hgamal/midiclock/doc/midiclock_schematics.pdf

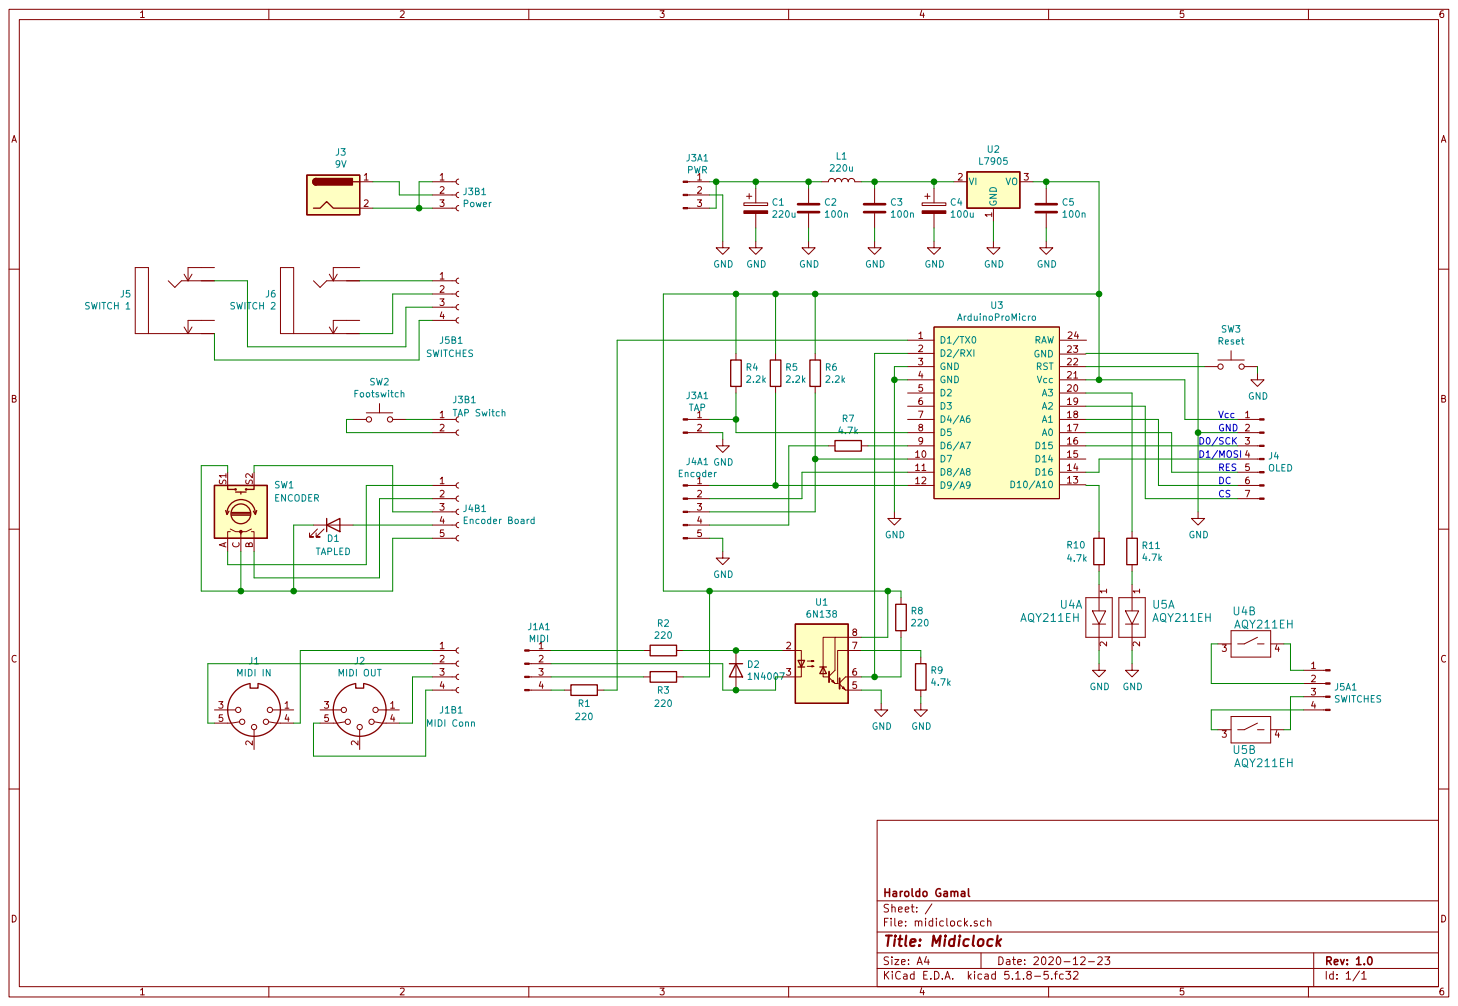
[picture p9: page 1]

File: midiclock.sch Sheet: / Haroldo Gamal
