hgamal/midiclock/doc/Pro-Micro-v10.pdf

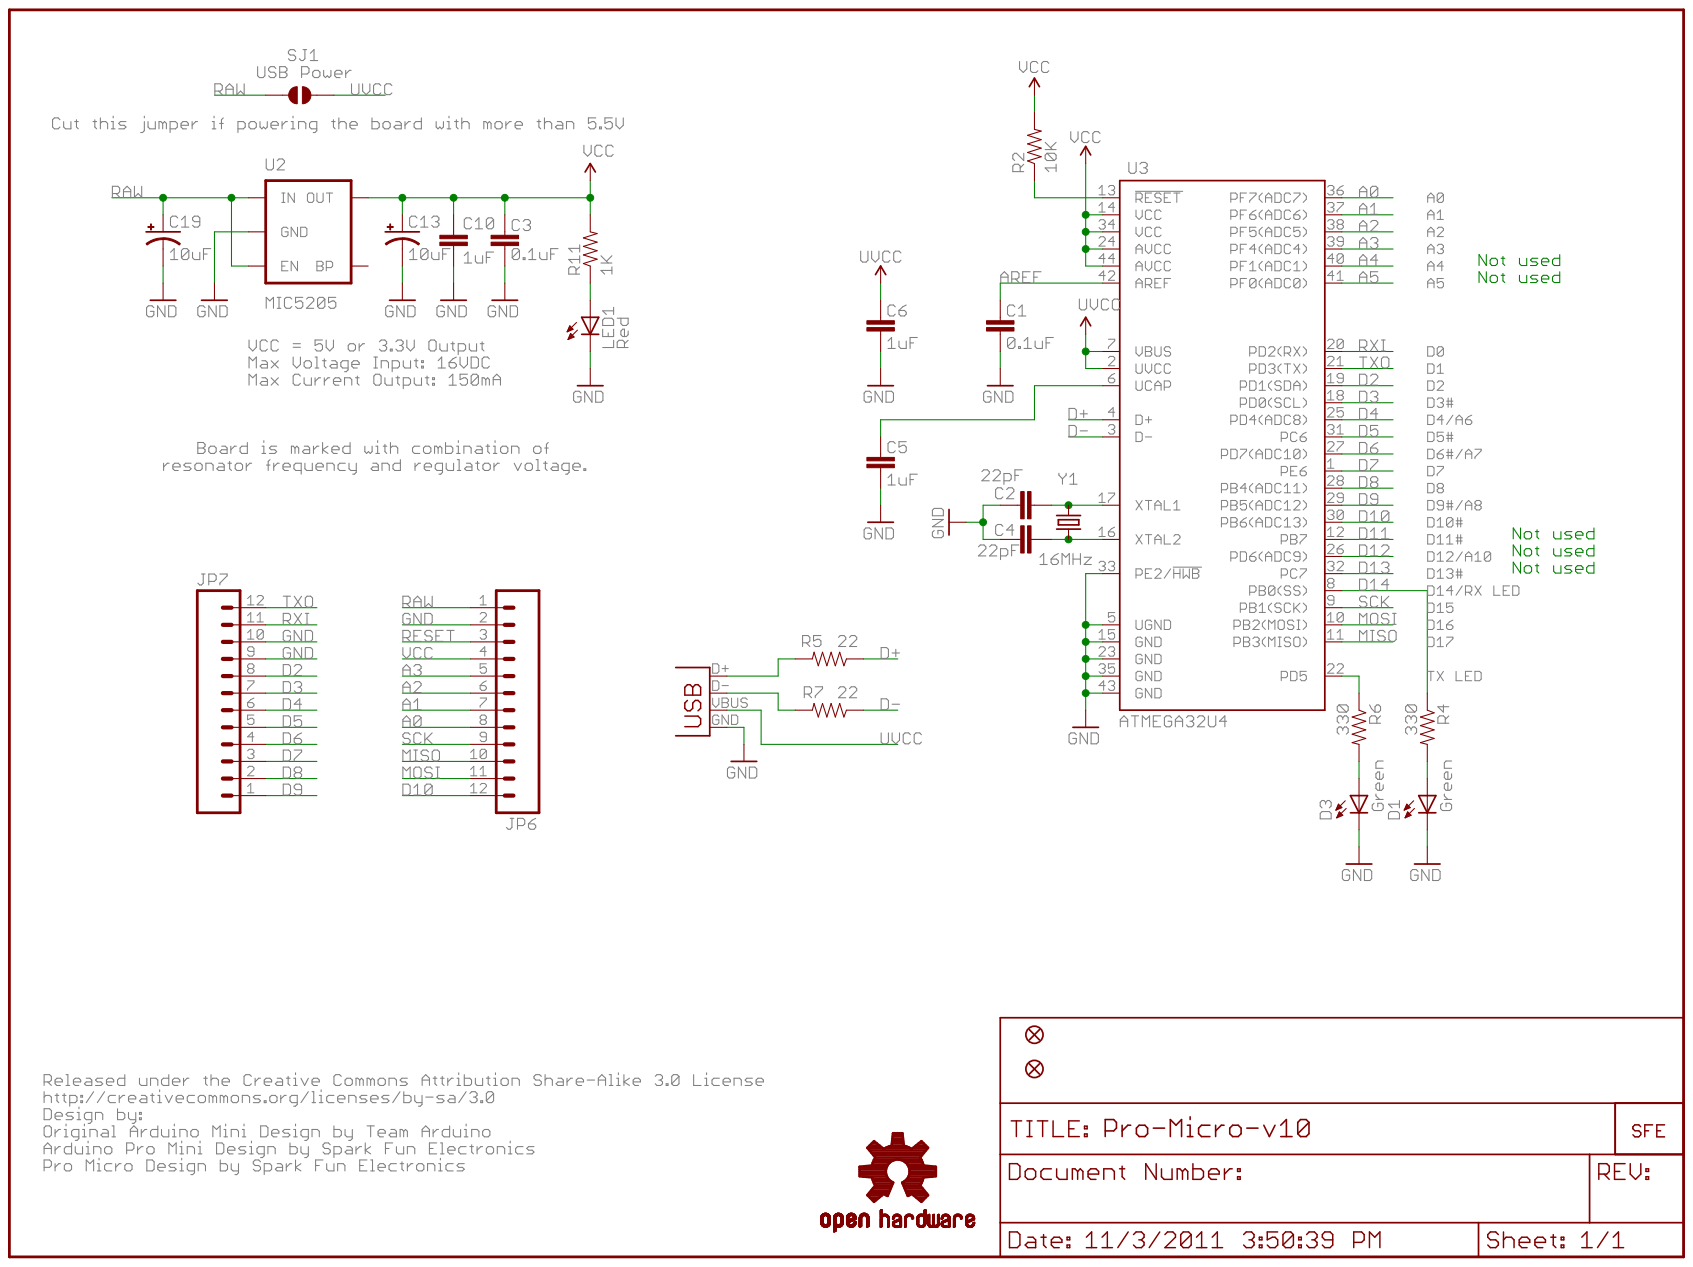
[picture p10: page 1]
