hgamal/midiclock/(commit log)

2020-12-15 MOD: fixing lack of initialization of BPM counter
    [main.cpp]
2020-12-16 BUG: fix save initial BPM counting
    [main.cpp, midi.h]
2020-12-20 BUG: correcting MIDI clock generation MOD: better UG8LIB encapsulation MOD: strong TAP tempo modeling, without treating key processing
    [main.cpp]
2020-12-20 MOD: fix some function and variables names MOD: moving buttons processing to the main loop MOD: moving variable declaration close to the place they are used
    [main.cpp]
2020-12-23 MOD: recovering arduino enviroment
2020-12-23 MOD: changing wsitch names from button to switch
2020-12-23 MOD: enters electronic circuit
    [midiclock.kicad_pcb, midiclock.sch]
2020-12-24 MOD: finishing schematics file MOD: adding more documentation
    [midiclock.sch]
2025-04-28 Fix typo & remove whitespaces
    [main.cpp]
